nunosousa/GC_Video_Adapter/HDL/simulation/gc_dv_422_to_444_tb01.pdf

# Time

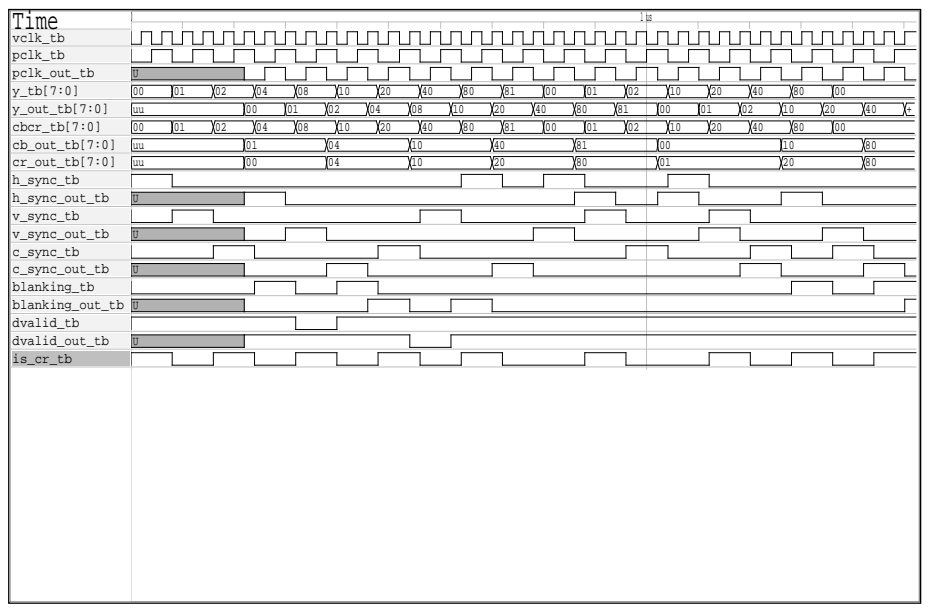
[picture p1: page 1]
vclk_tb pclk_tb pclk_out_tb y_tb[7:0] y_out_tb[7:0] cbcr_tb[7:0] cb_out_tb[7:0] cr_out_tb[7:0] h_sync_tb h_sync_out_tb v_sync_tb v_sync_out_tb c_sync_tb c_sync_out_tb blanking_tb blanking_out_tb dvalid_tb dvalid_out_tb is_cr_tb
