nunosousa/GC_Video_Adapter/HDL/simulation/gc_dv_decode_tb01.pdf

# Time

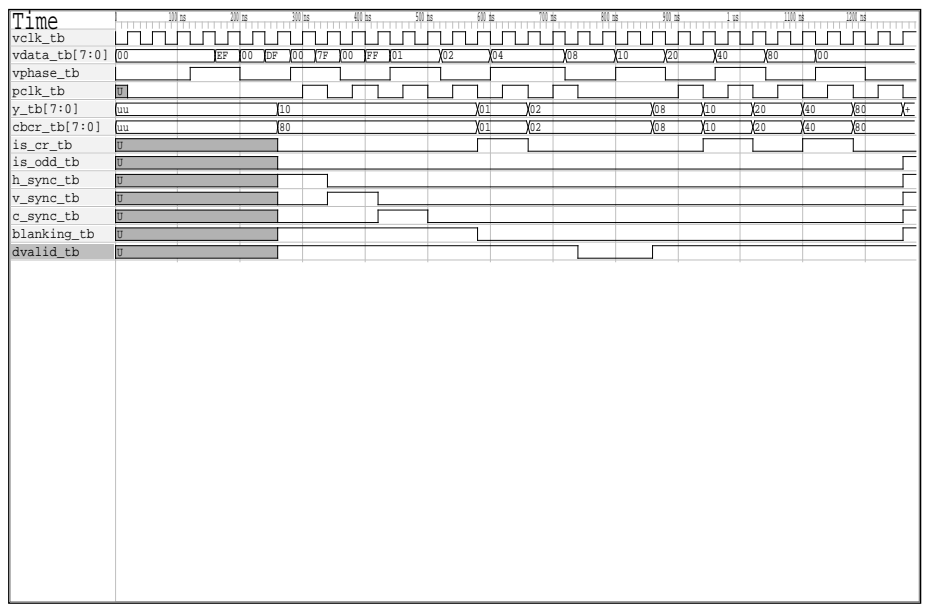
[picture p2: page 1]
vclk_tb vdata_tb[7:0] vphase_tb pclk_tb y_tb[7:0] cbcr_tb[7:0] is_cr_tb is_odd_tb h_sync_tb v_sync_tb c_sync_tb blanking_tb dvalid_tb
