nunosousa/GC_Video_Adapter/HDL/simulation/gc_dv_top_level_tb01.pdf

# Time

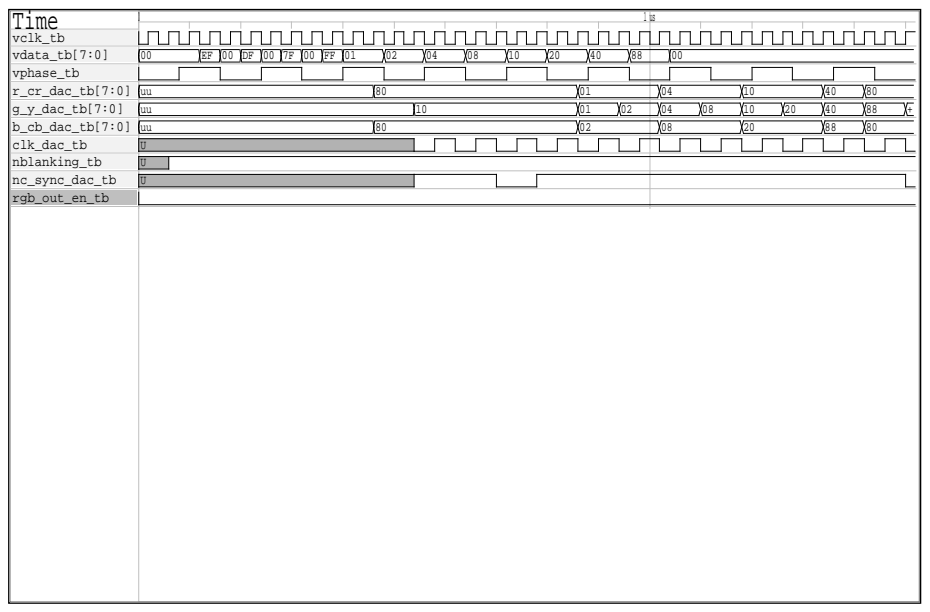
[picture p3: page 1]
vclk_tb vdata_tb[7:0] vphase_tb r_cr_dac_tb[7:0] g_y_dac_tb[7:0] b_cb_dac_tb[7:0] clk_dac_tb nblanking_tb nc_sync_dac_tb rgb_out_en_tb
