nunosousa/GC_Video_Adapter/HDL/simulation/gc_dv_video_DAC_tb01.pdf

# Time

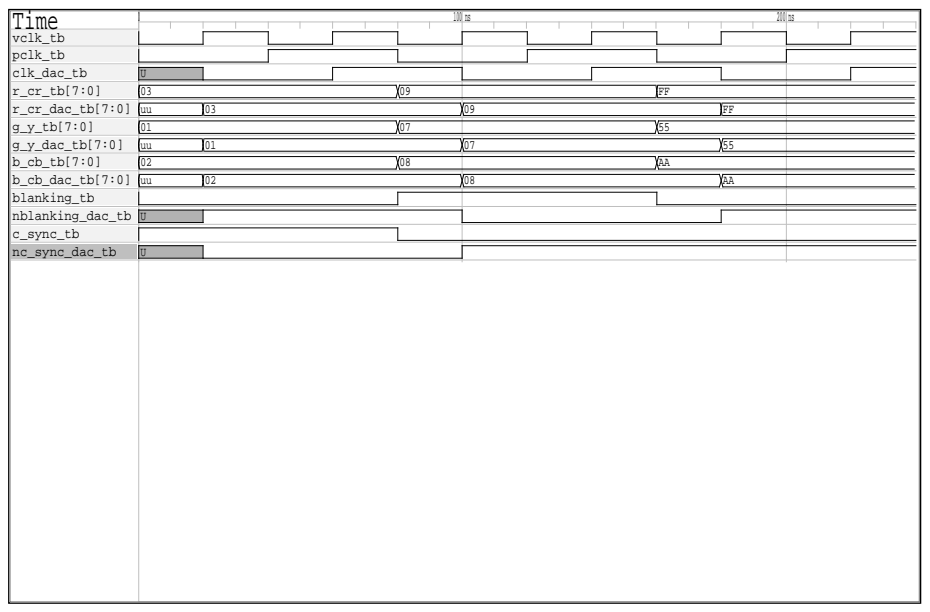
[picture p4: page 1]
vclk_tb pclk_tb clk_dac_tb r_cr_tb[7:0] r_cr_dac_tb[7:0] g_y_tb[7:0] g_y_dac_tb[7:0] b_cb_tb[7:0] b_cb_dac_tb[7:0] blanking_tb nblanking_dac_tb c_sync_tb nc_sync_dac_tb
