nunosousa/GC_Video_Adapter/Hardware/GC_Video_Adapter.kicad_pcb

## KiCad design Hardware/GC_Video_Adapter.kicad_pcb (2024-04-14)

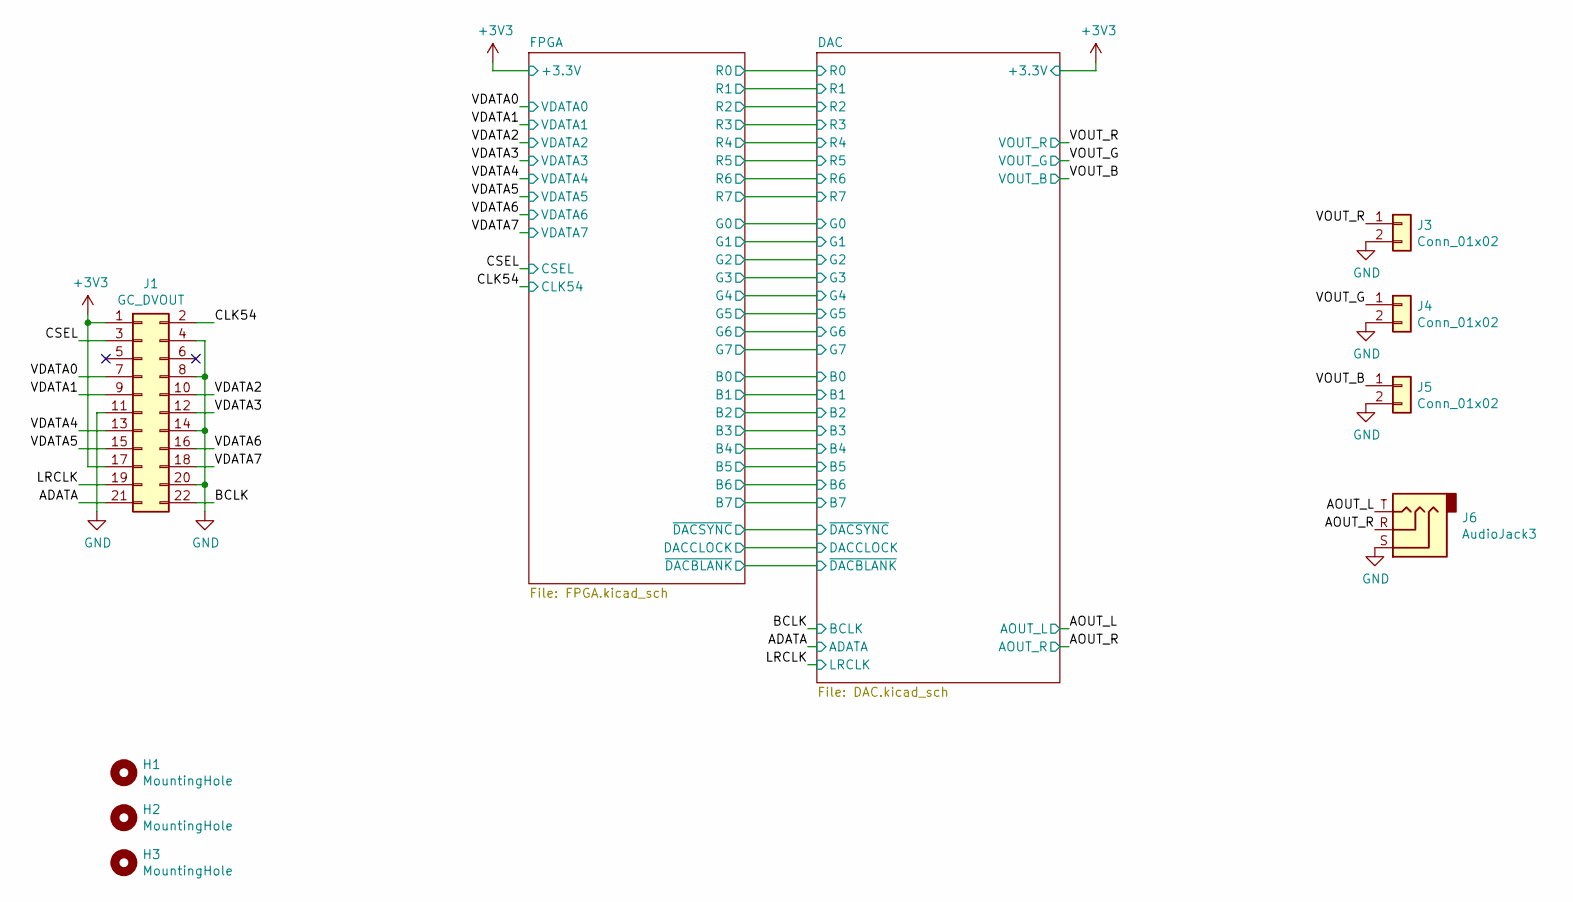
[picture p6: schematic GC_Video_Adapter.kicad_sch]

Parts:
H1, H2, H3: MountingHole; MountingHole_3.2mm_M3
J1: GC_DVOUT; GC-Connector-01; Manufacturer Part Number GC-Connector-01
J3, J4, J5: Conn_01x02; SolderWire-0.5sqmm_1x02_P4.6mm_D0.9mm_OD2.1mm
J6: AudioJack3; Jack_3.5mm_CUI_SJ1-3533NG_Horizontal; Manufacturer Part Number SJ1-3533NG

Connections:
+3V3: J1.1, J1.17; also elsewhere on the board
/ADATA: J1.21; also elsewhere on the board
/AOUT_L: J6.T; also elsewhere on the board
/AOUT_R: J6.R; also elsewhere on the board
/BCLK: J1.22; also elsewhere on the board
/CLK54: J1.2; also elsewhere on the board
/CSEL: J1.3; also elsewhere on the board
/LRCLK: J1.19; also elsewhere on the board
/VDATA0: J1.7; also elsewhere on the board
/VDATA1: J1.9; also elsewhere on the board
/VDATA2: J1.10; also elsewhere on the board
/VDATA3: J1.12; also elsewhere on the board
/VDATA4: J1.13; also elsewhere on the board
/VDATA5: J1.15; also elsewhere on the board
/VDATA6: J1.16; also elsewhere on the board
/VDATA7: J1.18; also elsewhere on the board
/VOUT_B: J5.1; also elsewhere on the board
/VOUT_G: J4.1; also elsewhere on the board
/VOUT_R: J3.1; also elsewhere on the board
GND: J1.4, J1.8, J1.11, J1.14, J1.20, J3.2, J4.2, J5.2, J6.S; also elsewhere on the board

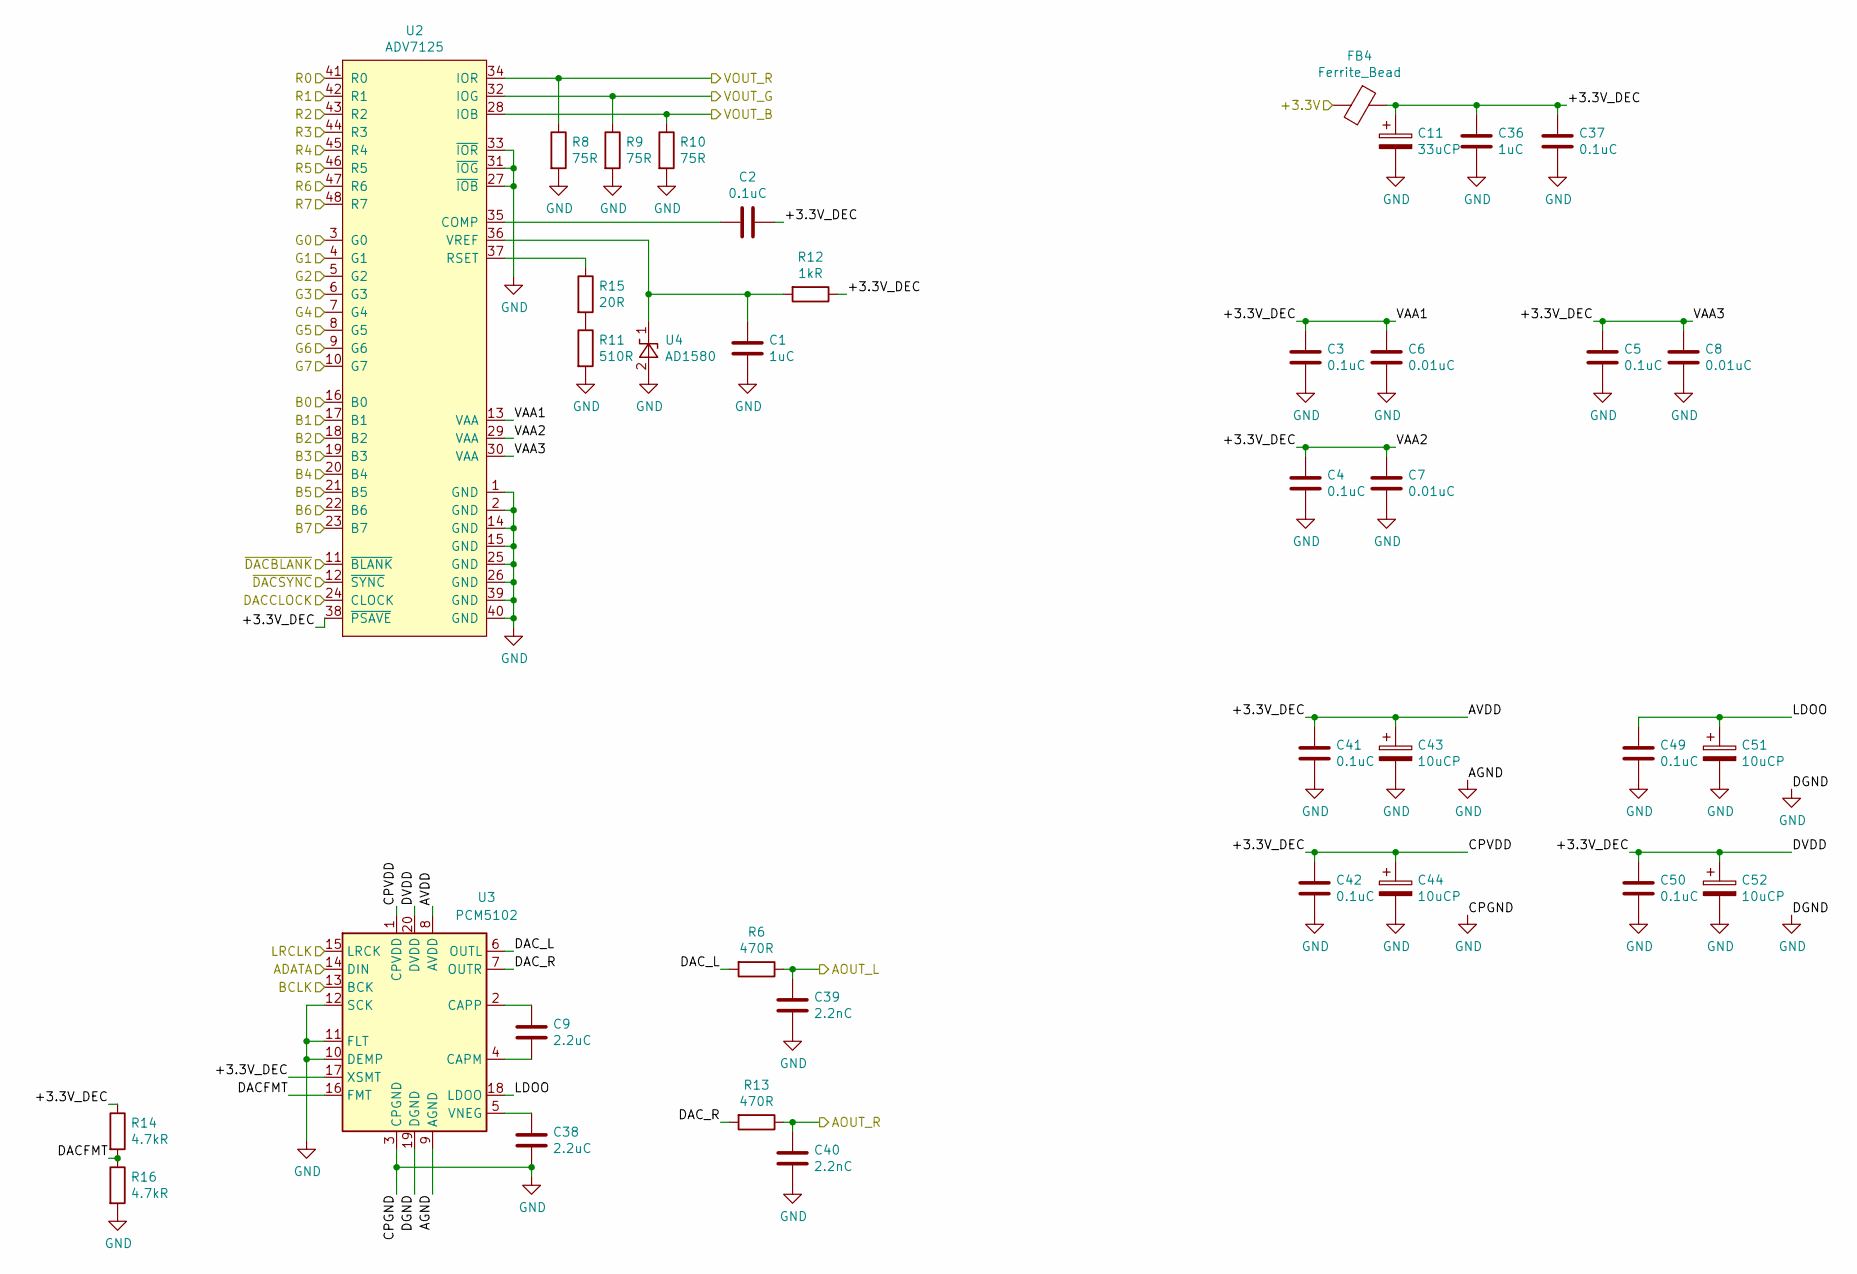
[picture p7: schematic DAC.kicad_sch]

Parts:
C1, C36: 1uC; C_0805_2012Metric_Pad1.18x1.45mm_HandSolder; Manufacturer Part Number CC0805MKX7R7BB105
C2, C3, C4, C5, C37, C41, C42, C49, C50: 0.1uC; C_0805_2012Metric_Pad1.18x1.45mm_HandSolder; Manufacturer Part Number AC0805KRX7R7BB104
C6, C7, C8: 0.01uC; C_0805_2012Metric_Pad1.18x1.45mm_HandSolder; Manufacturer Part Number CC0805KRX7R9BB103
C9, C38: 2.2uC; C_0805_2012Metric_Pad1.18x1.45mm_HandSolder; Manufacturer Part Number TMK212B7225KG-TR
C11: 33uCP; CP_EIA-3528-21_Kemet-B_Pad1.50x2.35mm_HandSolder; Manufacturer Part Number TAJB336K006RNJ
C39, C40: 2.2nC; C_0805_2012Metric_Pad1.18x1.45mm_HandSolder; Manufacturer Part Number FCP0805H222J-J1
C43, C44, C51, C52: 10uCP; CP_EIA-3216-18_Kemet-A_Pad1.58x1.35mm_HandSolder; Manufacturer Part Number TAJA106K006SNJ
FB4: Ferrite_Bead; L_0805_2012Metric_Pad1.15x1.40mm_HandSolder; Manufacturer Part Number BLM21SP471SH1D
R6, R13: 470R; R_0805_2012Metric_Pad1.20x1.40mm_HandSolder; Manufacturer Part Number CRCW0805470RJNEA
R8, R9, R10: 75R; R_0805_2012Metric_Pad1.20x1.40mm_HandSolder; Manufacturer Part Number RC0805FR-0775RL
R11: 510R; R_0805_2012Metric_Pad1.20x1.40mm_HandSolder; Manufacturer Part Number RT0805BRD07510RL
R12: 1kR; R_0805_2012Metric_Pad1.20x1.40mm_HandSolder; Manufacturer Part Number RC0805FR-071KL
R14, R16: 4.7kR; R_0805_2012Metric_Pad1.20x1.40mm_HandSolder; Manufacturer Part Number RC0805FR-074K7L
R15: 20R; R_0805_2012Metric_Pad1.20x1.40mm_HandSolder; Manufacturer Part Number RT0805BRD0720RL
U2: ADV7125; LQFP-48_7x7mm_P0.5mm; Manufacturer Part Number ADV7125KSTZ50-REEL
U3: PCM5102; TSSOP-20_4.4x6.5mm_P0.65mm; Manufacturer Part Number PCM5102APWR
U4: AD1580; SOT-23; Manufacturer Part Number AD1580BRTZ-REEL7

Connections:
+3V3: FB4.2; also elsewhere on the board
/ADATA: U3.14 (DIN); also elsewhere on the board
/AOUT_L: C39.1, R6.1; also elsewhere on the board
/AOUT_R: C40.1, R13.1; also elsewhere on the board
/BCLK: U3.13 (BCK); also elsewhere on the board
/DAC/+3.3V_DEC: C2.1, C3.1, C4.1, C5.1, C6.1, C7.1, C8.1, C11.1, C36.1, C37.1, C41.1, C42.1, C43.1, C44.1, C50.1, C52.1, FB4.1, R12.1, R14.1, U2.13 (VAA), U2.29 (VAA), U2.30 (VAA), U2.38 (~PSAVE), U3.1 (CPVDD), U3.8 (AVDD), U3.17 (XSMT), U3.20 (DVDD)
/DAC/B0: U2.16 (B0); also elsewhere on the board
/DAC/B1: U2.17 (B1); also elsewhere on the board
/DAC/B2: U2.18 (B2); also elsewhere on the board
/DAC/B3: U2.19 (B3); also elsewhere on the board
/DAC/B4: U2.20 (B4); also elsewhere on the board
/DAC/B5: U2.21 (B5); also elsewhere on the board
/DAC/B6: U2.22 (B6); also elsewhere on the board
/DAC/B7: U2.23 (B7); also elsewhere on the board
/DAC/DACCLOCK: U2.24 (CLOCK); also elsewhere on the board
/DAC/DACFMT: R14.2, R16.1, U3.16 (FMT)
/DAC/DAC_L: R6.2, U3.6 (OUTL)
/DAC/DAC_R: R13.2, U3.7 (OUTR)
/DAC/G0: U2.3 (G0); also elsewhere on the board
/DAC/G1: U2.4 (G1); also elsewhere on the board
/DAC/G2: U2.5 (G2); also elsewhere on the board
/DAC/G3: U2.6 (G3); also elsewhere on the board
/DAC/G4: U2.7 (G4); also elsewhere on the board
/DAC/G5: U2.8 (G5); also elsewhere on the board
/DAC/G6: U2.9 (G6); also elsewhere on the board
/DAC/G7: U2.10 (G7); also elsewhere on the board
/DAC/LDOO: C49.1, C51.1, U3.18 (LDOO)
/DAC/R0: U2.41 (R0); also elsewhere on the board
/DAC/R1: U2.42 (R1); also elsewhere on the board
/DAC/R2: U2.43 (R2); also elsewhere on the board
/DAC/R3: U2.44 (R3); also elsewhere on the board
/DAC/R4: U2.45 (R4); also elsewhere on the board
/DAC/R5: U2.46 (R5); also elsewhere on the board
/DAC/R6: U2.47 (R6); also elsewhere on the board
/DAC/R7: U2.48 (R7); also elsewhere on the board
/DAC/~DACBLANK: U2.11 (~BLANK); also elsewhere on the board
/DAC/~DACSYNC: U2.12 (~SYNC); also elsewhere on the board
/LRCLK: U3.15 (LRCK); also elsewhere on the board
/VOUT_B: R10.1, U2.28 (IOB); also elsewhere on the board
/VOUT_G: R9.1, U2.32 (IOG); also elsewhere on the board
/VOUT_R: R8.1, U2.34 (IOR); also elsewhere on the board
GND: C1.2, C3.2, C4.2, C5.2, C6.2, C7.2, C8.2, C11.2, C36.2, C37.2, C38.2, C39.2, C40.2, C41.2, C42.2, C43.2, C44.2, C49.2, C50.2, C51.2, C52.2, R8.2, R9.2, R10.2, R11.2, R16.2, U2.1 (GND), U2.2 (GND), U2.14 (GND), U2.15 (GND), U2.25 (GND), U2.26 (GND), U2.27 (~IOB), U2.31 (~IOG), U2.33 (~IOR), U2.39 (GND), U2.40 (GND), U3.3 (CPGND), U3.9 (AGND), U3.10 (DEMP), U3.11 (FLT), U3.12 (SCK), U3.19 (DGND), U4.2 (A); also elsewhere on the board
unnamed: C1.1, R12.2, U2.36 (VREF), U4.1 (K)
unnamed: C2.2, U2.35 (COMP)
unnamed: C9.1, U3.2 (CAPP)
unnamed: C9.2, U3.4 (CAPM)
unnamed: C38.1, U3.5 (VNEG)
unnamed: R11.1, R15.2
unnamed: R15.1, U2.37 (RSET)

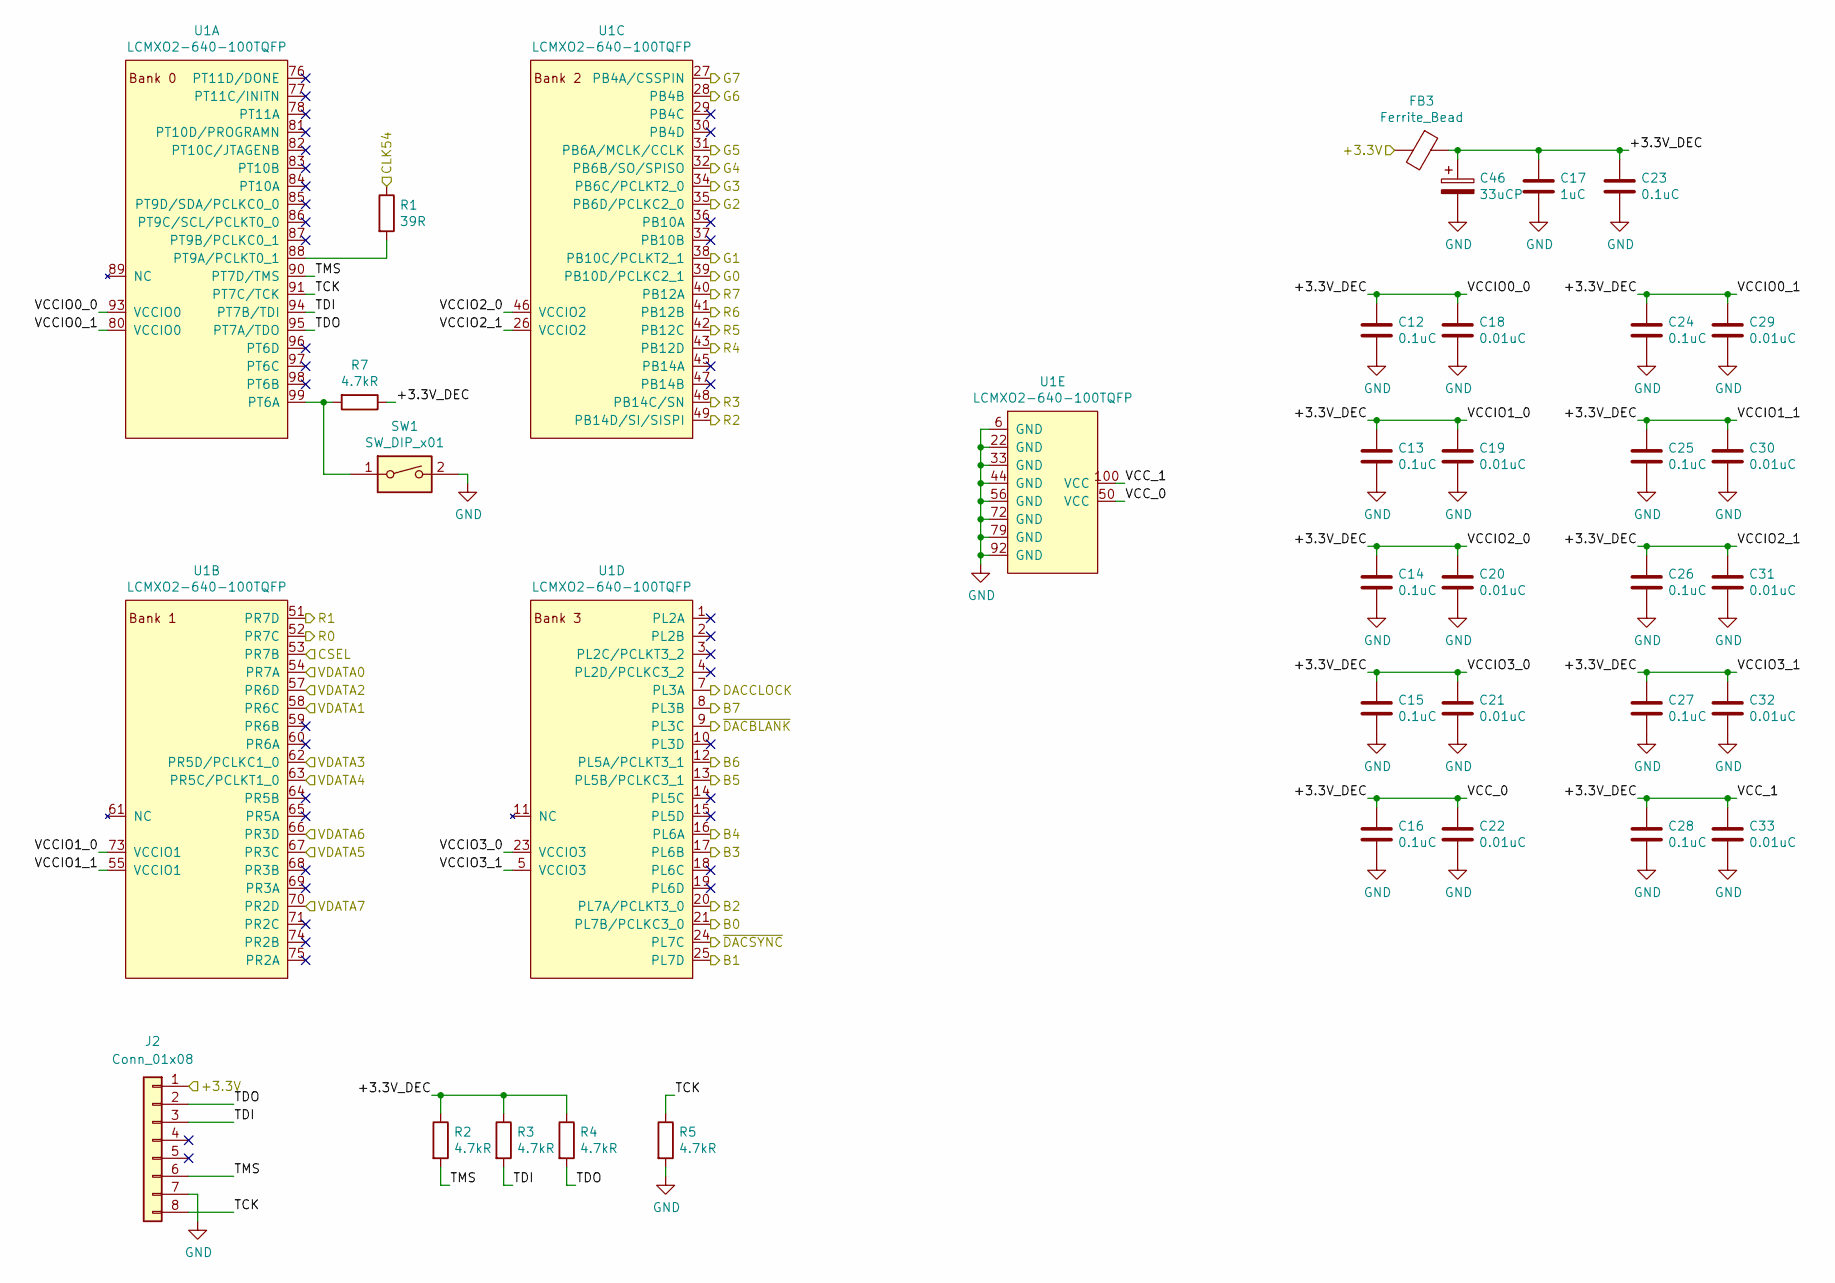
[picture p8: schematic FPGA.kicad_sch]

Parts:
C12, C13, C14, C15, C16, C23, C24, C25, C26, C27, C28: 0.1uC; C_0805_2012Metric_Pad1.18x1.45mm_HandSolder; Manufacturer Part Number AC0805KRX7R7BB104
C17: 1uC; C_0805_2012Metric_Pad1.18x1.45mm_HandSolder; Manufacturer Part Number CC0805MKX7R7BB105
C18, C19, C20, C21, C22, C29, C30, C31, C32, C33: 0.01uC; C_0805_2012Metric_Pad1.18x1.45mm_HandSolder; Manufacturer Part Number CC0805KRX7R9BB103
C46: 33uCP; CP_EIA-3528-21_Kemet-B_Pad1.50x2.35mm_HandSolder; Manufacturer Part Number TAJB336K006RNJ
FB3: Ferrite_Bead; L_0805_2012Metric_Pad1.15x1.40mm_HandSolder; Manufacturer Part Number BLM21SP471SH1D
J2: Conn_01x08; PinHeader_1x08_P2.54mm_Vertical; Manufacturer Part Number 0022284081
R1: 39R; R_0805_2012Metric_Pad1.20x1.40mm_HandSolder; Manufacturer Part Number RC0805FR-0739RL
R2, R3, R4, R5, R7: 4.7kR; R_0805_2012Metric_Pad1.20x1.40mm_HandSolder; Manufacturer Part Number RC0805FR-074K7L
SW1: SW_DIP_x01; SW_DIP_SPSTx01_Slide_6.7x4.1mm_W7.62mm_P2.54mm_LowProfile; Manufacturer Part Number DS04-254-2L-01BK
U1: LCMXO2-640-100TQFP; TQFP-100_14x14mm_P0.5mm; Manufacturer Part Number LCMXO2-640HC-4TG100I

Connections:
+3V3: FB3.2, J2.1; also elsewhere on the board
/CLK54: R1.1; also elsewhere on the board
/CSEL: U1.53 (PR7B); also elsewhere on the board
/DAC/B0: U1.21 (PL7B/PCLKC3_0); also elsewhere on the board
/DAC/B1: U1.25 (PL7D); also elsewhere on the board
/DAC/B2: U1.20 (PL7A/PCLKT3_0); also elsewhere on the board
/DAC/B3: U1.17 (PL6B); also elsewhere on the board
/DAC/B4: U1.16 (PL6A); also elsewhere on the board
/DAC/B5: U1.13 (PL5B/PCLKC3_1); also elsewhere on the board
/DAC/B6: U1.12 (PL5A/PCLKT3_1); also elsewhere on the board
/DAC/B7: U1.8 (PL3B); also elsewhere on the board
/DAC/DACCLOCK: U1.7 (PL3A); also elsewhere on the board
/DAC/G0: U1.39 (PB10D/PCLKC2_1); also elsewhere on the board
/DAC/G1: U1.38 (PB10C/PCLKT2_1); also elsewhere on the board
/DAC/G2: U1.35 (PB6D/PCLKC2_0); also elsewhere on the board
/DAC/G3: U1.34 (PB6C/PCLKT2_0); also elsewhere on the board
/DAC/G4: U1.32 (PB6B/SO/SPISO); also elsewhere on the board
/DAC/G5: U1.31 (PB6A/MCLK/CCLK); also elsewhere on the board
/DAC/G6: U1.28 (PB4B); also elsewhere on the board
/DAC/G7: U1.27 (PB4A/CSSPIN); also elsewhere on the board
/DAC/R0: U1.52 (PR7C); also elsewhere on the board
/DAC/R1: U1.51 (PR7D); also elsewhere on the board
/DAC/R2: U1.49 (PB14D/SI/SISPI); also elsewhere on the board
/DAC/R3: U1.48 (PB14C/SN); also elsewhere on the board
/DAC/R4: U1.43 (PB12D); also elsewhere on the board
/DAC/R5: U1.42 (PB12C); also elsewhere on the board
/DAC/R6: U1.41 (PB12B); also elsewhere on the board
/DAC/R7: U1.40 (PB12A); also elsewhere on the board
/DAC/~DACBLANK: U1.9 (PL3C); also elsewhere on the board
/DAC/~DACSYNC: U1.24 (PL7C); also elsewhere on the board
/FPGA/+3.3V_DEC: C12.1, C13.1, C14.1, C15.1, C16.1, C17.1, C18.1, C19.1, C20.1, C21.1, C22.1, C23.1, C24.1, C25.1, C26.1, C27.1, C28.1, C29.1, C30.1, C31.1, C32.1, C33.1, C46.1, FB3.1, R2.1, R3.1, R4.1, R7.1, U1.5 (VCCIO3), U1.23 (VCCIO3), U1.26 (VCCIO2), U1.46 (VCCIO2), U1.50 (VCC), U1.55 (VCCIO1), U1.73 (VCCIO1), U1.80 (VCCIO0), U1.93 (VCCIO0), U1.100 (VCC)
/FPGA/TCK: J2.8, R5.1, U1.91 (PT7C/TCK)
/FPGA/TDI: J2.3, R3.2, U1.94 (PT7B/TDI)
/FPGA/TDO: J2.2, R4.2, U1.95 (PT7A/TDO)
/FPGA/TMS: J2.6, R2.2, U1.90 (PT7D/TMS)
/VDATA0: U1.54 (PR7A); also elsewhere on the board
/VDATA1: U1.58 (PR6C); also elsewhere on the board
/VDATA2: U1.57 (PR6D); also elsewhere on the board
/VDATA3: U1.62 (PR5D/PCLKC1_0); also elsewhere on the board
/VDATA4: U1.63 (PR5C/PCLKT1_0); also elsewhere on the board
/VDATA5: U1.67 (PR3C); also elsewhere on the board
/VDATA6: U1.66 (PR3D); also elsewhere on the board
/VDATA7: U1.70 (PR2D); also elsewhere on the board
GND: C12.2, C13.2, C14.2, C15.2, C16.2, C17.2, C18.2, C19.2, C20.2, C21.2, C22.2, C23.2, C24.2, C25.2, C26.2, C27.2, C28.2, C29.2, C30.2, C31.2, C32.2, C33.2, C46.2, J2.7, R5.2, SW1.2, U1.6 (GND), U1.22 (GND), U1.33 (GND), U1.44 (GND), U1.56 (GND), U1.72 (GND), U1.79 (GND), U1.92 (GND); also elsewhere on the board
unnamed: R1.2, U1.88 (PT9A/PCLKT0_1)
unnamed: R7.2, SW1.1, U1.99 (PT6A)

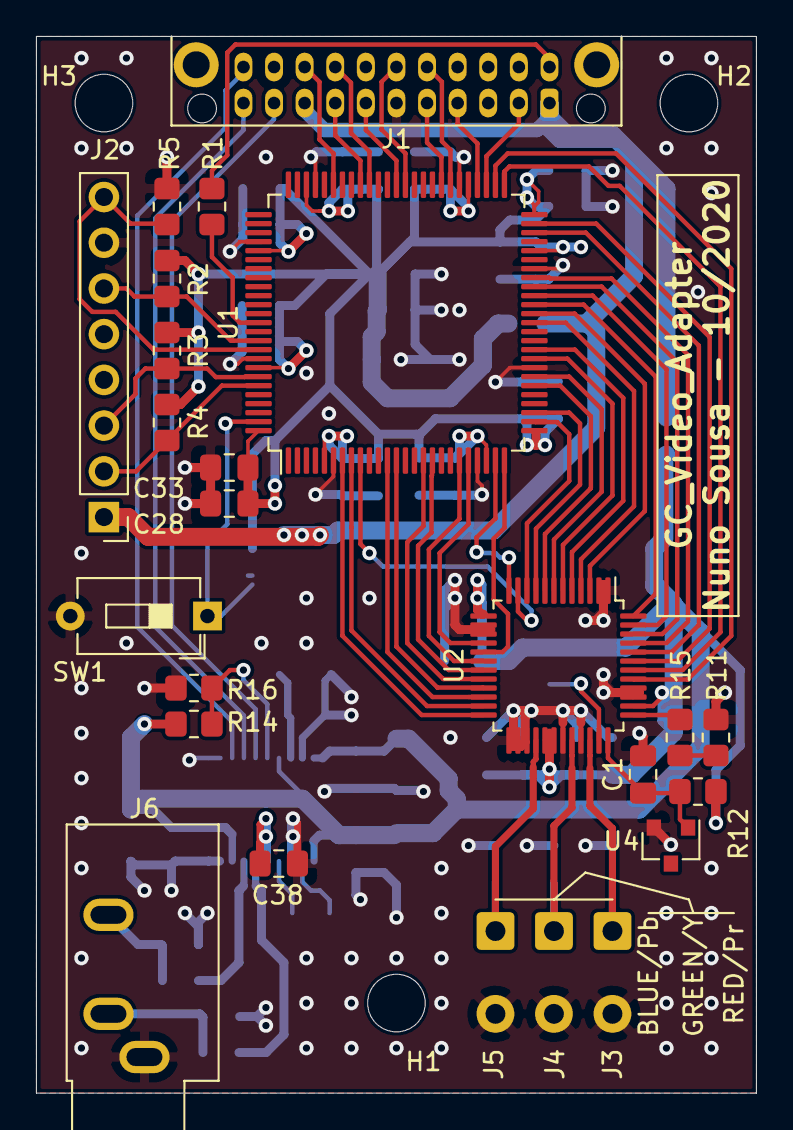
[picture p9: board GC_Video_Adapter.kicad_pcb from above]

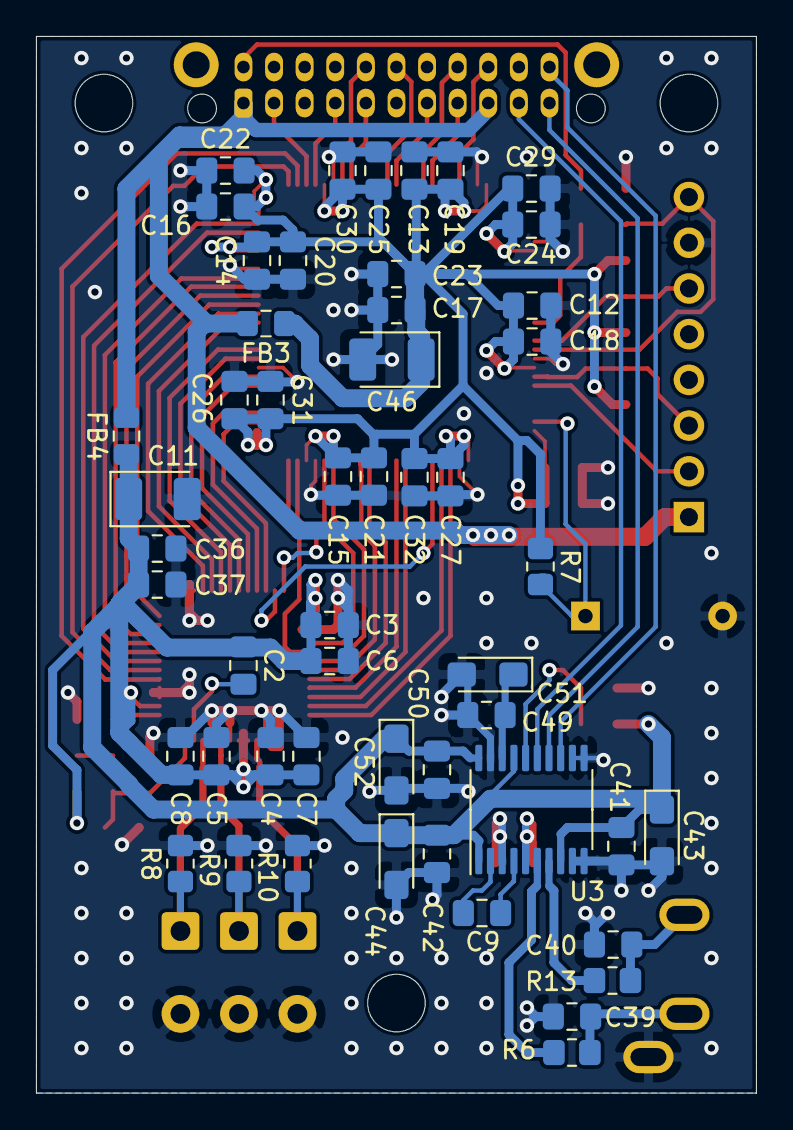
[picture p10: board GC_Video_Adapter.kicad_pcb from below]

Board: 4 copper layers, 40.0 x 58.7 mm, 78 parts (51 on the bottom side), 66 nets.
