nunosousa/GC_Video_Adapter/(commit log)

2021-01-14 Progressed logic analisys.
    [filter.xlsx]
2021-02-09 Progressed updates.
    [filter.xlsx]
2021-03-01 Fixed bug on upsampling logic.
    [gc_dv_422_to_444.vhd]
2021-03-08 Replaced variables with signals to improve timing.
    [gc_dv_decode.vhd]
2024-04-14 Upgraded from Kicad 5 to Kicad 8.
    [DAC.kicad_sch, FPGA.kicad_sch, GC_Video_Adapter.kicad_pcb, GC_Video_Adapter.kicad_sch]
